EianX/vacuum-forming-machine/prototype/presentation/assembly.jpg

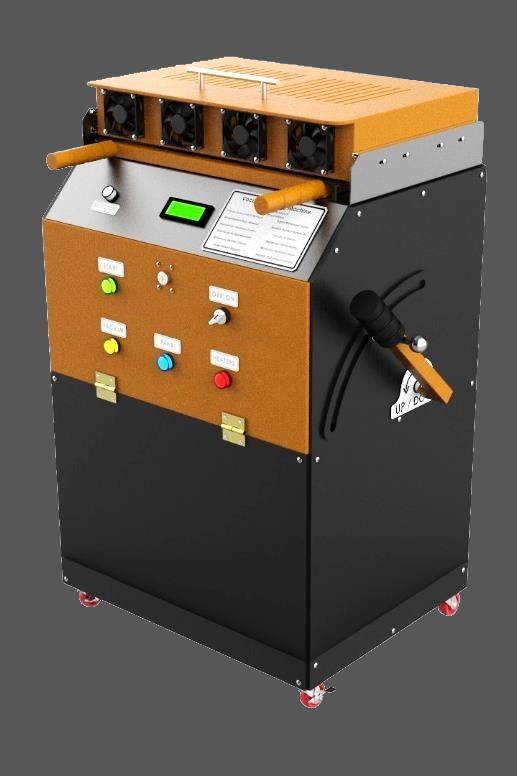
prototype/presentation/assembly.jpg
