EianX/vacuum-forming-machine/prototype/presentation/app.png

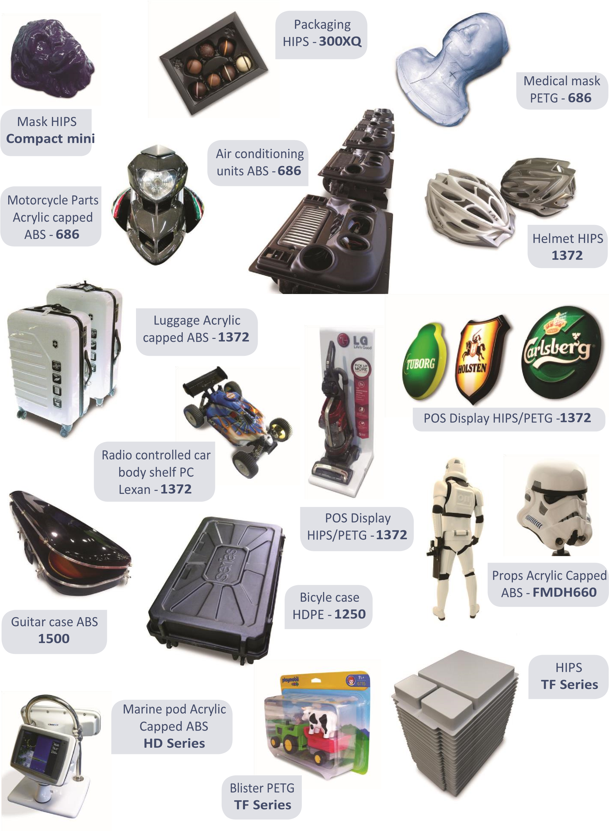
prototype/presentation/app.png
