EianX/vacuum-forming-machine/prototype/presentation/Project 2.pptx

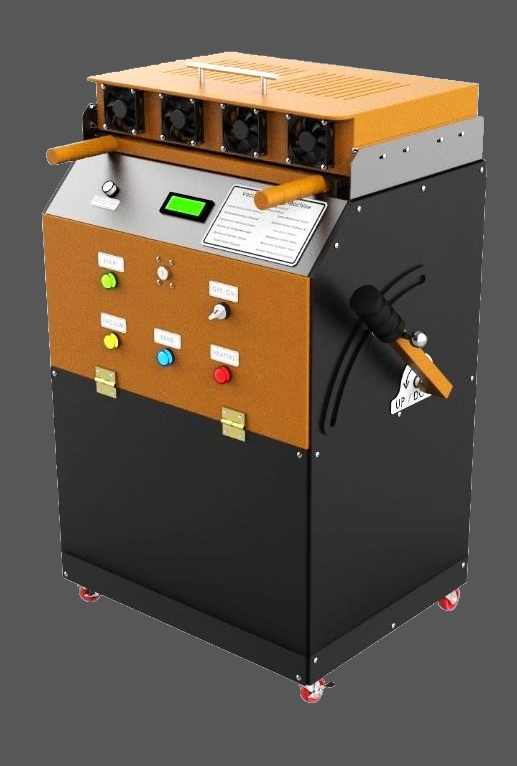
[picture p3: figure]

PROJECT 2

DESIGN & MANUFACTURING OF
MANUAL VACUUM FORMING MACHINE

Under the supervision of
Dr. Mahmoud Mohamed Saafan

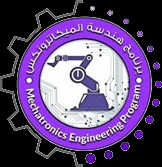
[picture p4: figure]

## Slide 2

WHAT IS IT ?

VACUUM FORMING MACHINE

Vacuum forming is a manufacturing method used to shape plastic materials. During the vacuum forming process, a sheet of plastic is heated and then pulled around a single mold using suction.
Vacuum forming is used for a wide range of manufacturing applications, ranging from small custom parts produced on desktop devices to large parts manufactured on automated industrial machinery.

## Slide 3

VACUUM FORMING MACHINE

DISCUSSION FLOW

Mechanical Portion
Hardware Portion
Software Portion
Applications

## Slide 4

Mechanical Portion

HASAN MOHAMED HASAN

MOHAMMED FARIED EL-SOFANY

IBRAHIM HAMED IBRAHIM ALI

KARIM KHALED ELSAYED

MEET THE TEAM

## Slide 5

Mechanical Portion

## Slide 6

VACUUM FORMING MACHINE

DISCUSSION FLOW

Mechanical Portion
Hardware Portion
Software Portion
Applications

## Slide 7

Hardware Portion

ABDELRAHMAN MAMDOUH IBRAHIM

HOSSAM AHMED ABD
EL-MAKSOUD

AMR USRY EL-SHERBINY

MOHAMED ABDALLAH HASSAN

MEET THE TEAM

## Slide 8

Hardware Portion

## Slide 9

VACUUM FORMING MACHINE

DISCUSSION FLOW

Mechanical Portion
Hardware Portion
Software Portion
Applications

## Slide 10

Software Portion

ABDELRAHMAN NASR MAAROOF

MAHMOUD ALI ABDALMONEM

MAHMOUD IBRAHIM OSMAN

MEET THE TEAM

## Slide 11

Software Portion

components

Programming definition:

All programs need data to be added to or removed from code. Data entered into a program, either by the programmer or digitally, are referred to as inputs. These inputs are stored in variables and used to run the program.
In order to keep the user informed about what is happening inside the program, a programmer may choose to include outputs. This is where the data from the program is shown to the user, either on screen or in the form of a physical output such as printouts or signals.

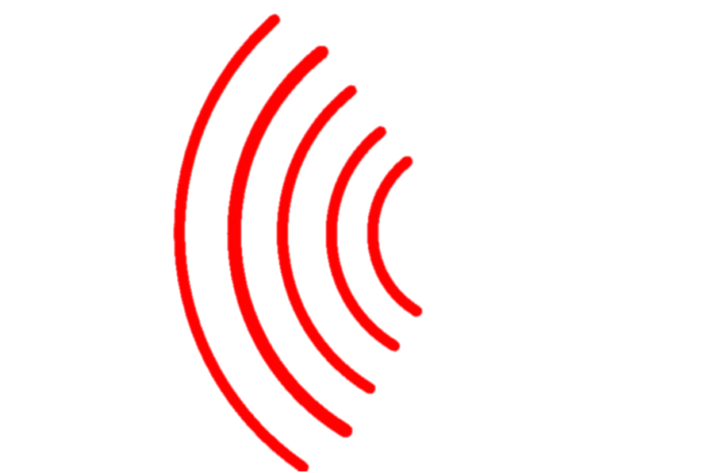
[picture p5: figure]
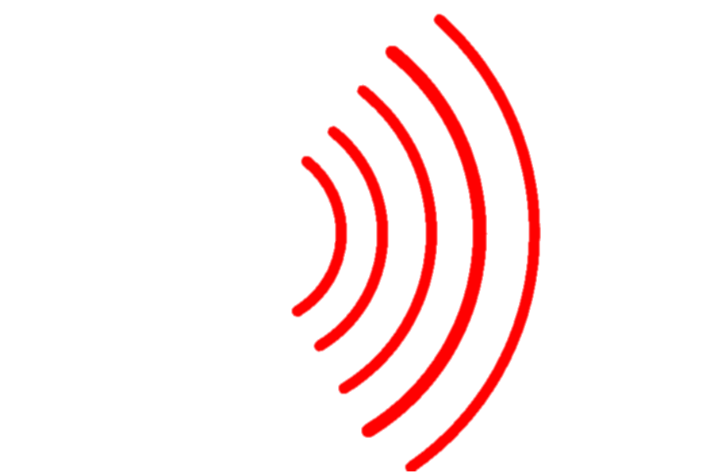
[picture p6: figure]

I/P

- Selector (ON\OFF)
- Encoder selector

O/P

- LCD
- AC lamps
- Buzzer

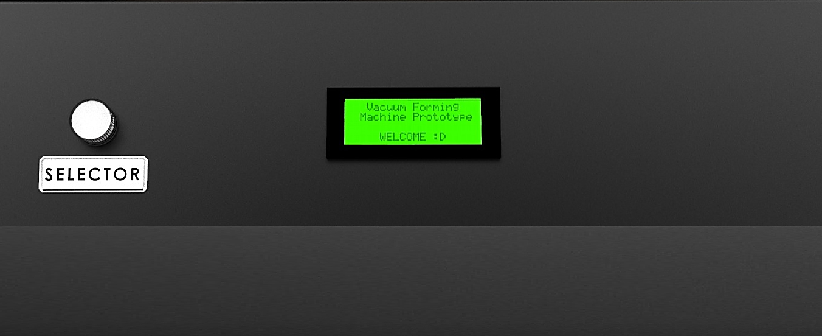
[picture p7: figure]
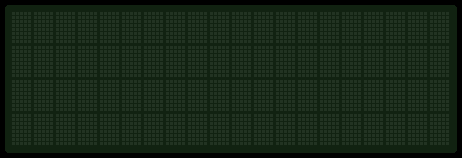
[picture p8: figure]
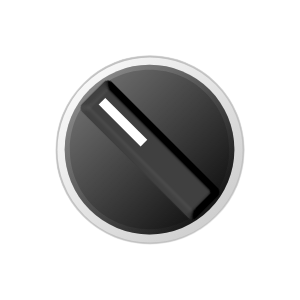
[picture p9: figure]
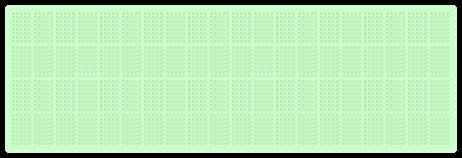
[picture p10: figure]
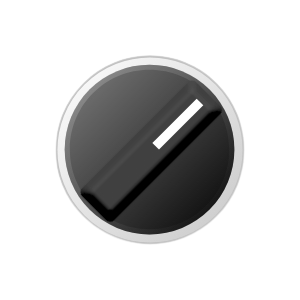
[picture p11: figure]
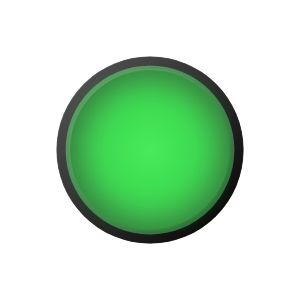
[picture p12: figure]

## Slide 12

Software Portion

ALGORITHM:

1. Import required libraries.
2. Assign due pins.
3. Initialize data variables (Material, Thickness & Temperatures).
4. Initialize LCD.
5. Display on LCD WELCOME message.

Part(1):

Initialization and Void setup.

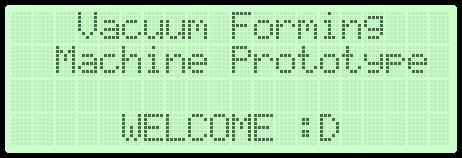
[picture p13: figure]

## Slide 13

Software Portion

ALGORITHM:

6. Display on LCD 1st Menu (Select Material).
7. Read encoder position.
8. Choose the material (PVC/Acrylic/PP).
9. Display on LCD 2nd Menu (Select thickness).
10. Read encoder position.
11. Choose the material thickness (300 µm / 650 µm / 1 mm).
12. Display on LCD 3rd Menu (Preview Chosen Data).
13. Read encoder position.
14. Choose (Continue or not):
  - Continue: Proceed to vacuum forming process.
  - Return: to 1st Menu.

Part(2):

Void loop Stage(0).

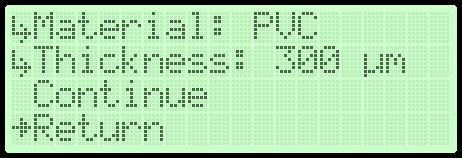
[picture p14: figure]
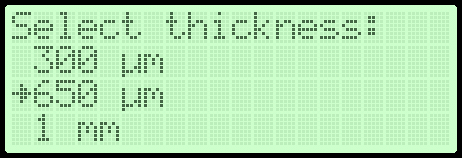
[picture p15: figure]
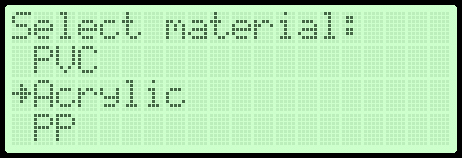
[picture p16: figure]

## Slide 14

VACUUM FORMING MACHINE

DISCUSSION FLOW

Mechanical Portion
Hardware Portion
Software Portion
Applications

## Slide 15

Applications

## Slide 16

VACUUM FORMING MACHINE

DISCUSSION FLOW

Mechanical Portion
Hardware Portion
Software Portion
Applications

## Slide 17

THANK YOU!
