EianX/vacuum-forming-machine/prototype/Software Z.pptx

## Software

Jahein
Abdo
osman

## Programing: Transform the inputs to outputs

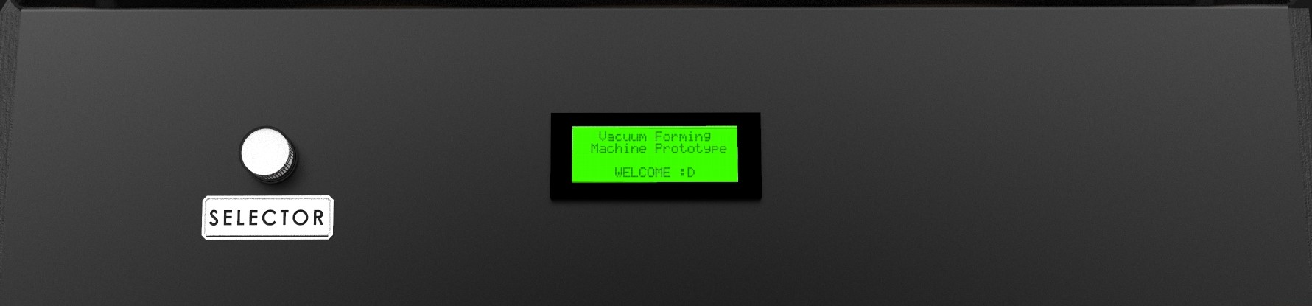
[picture p69: figure]
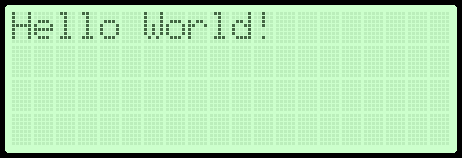
[picture p70: figure]
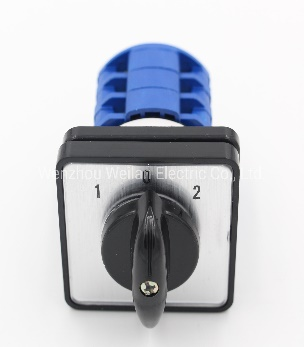
[picture p71: figure]

-Inputs
-Outputs
