EianX/vacuum-forming-machine/prototype/presentation/11.jpg

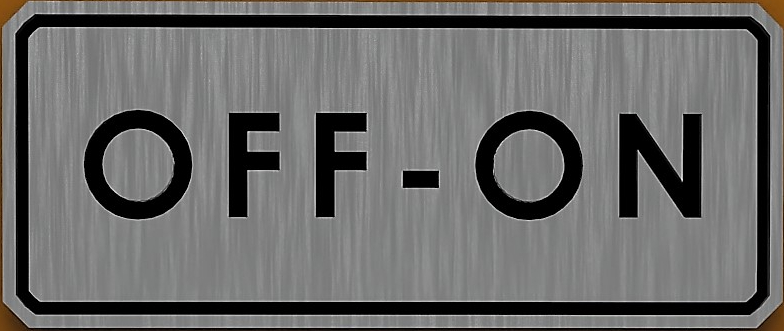
prototype/presentation/11.jpg
