EianX/vacuum-forming-machine/prototype/presentation/main.png

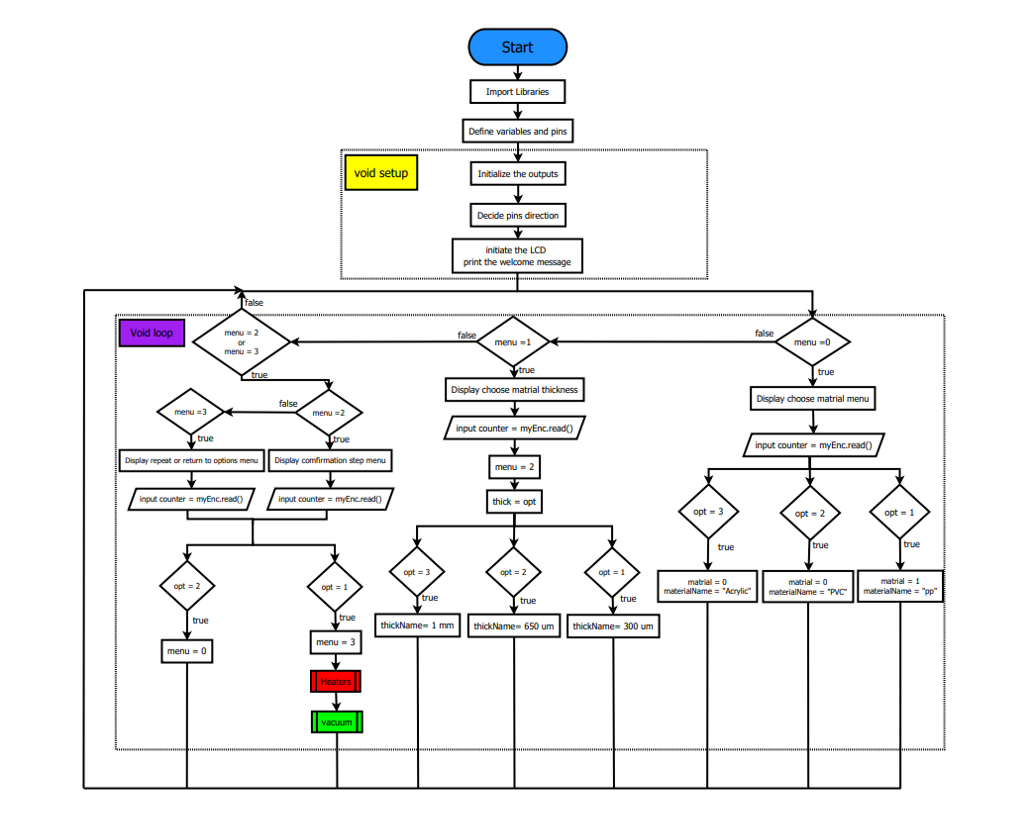
prototype/presentation/main.png
