EianX/vacuum-forming-machine/prototype/presentation/pb-white-br-3d-removebg-preview.png

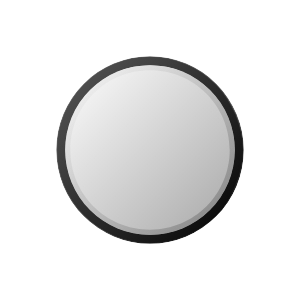
prototype/presentation/pb-white-br-3d-removebg-preview.png
