EianX/vacuum-forming-machine/prototype/presentation/pl-red-br-3d-removebg-preview.png

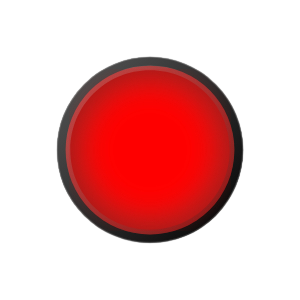
prototype/presentation/pl-red-br-3d-removebg-preview.png
