EianX/vacuum-forming-machine/prototype/presentation/screenshot (2)N.jpg

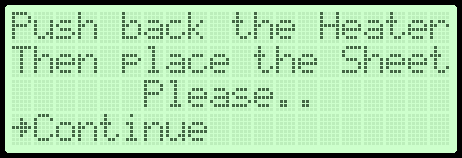
prototype/presentation/screenshot (2)N.jpg
