EianX/vacuum-forming-machine/prototype/presentation/screenshot (4)N.png

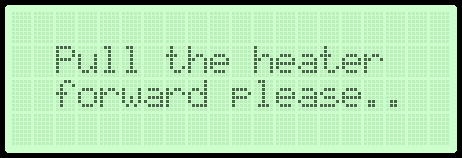
prototype/presentation/screenshot (4)N.png
