EianX/vacuum-forming-machine/prototype/presentation/screenshot (6)N.png

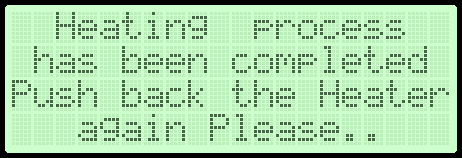
prototype/presentation/screenshot (6)N.png
