EianX/vacuum-forming-machine/prototype/presentation/screenshot (7)N.png

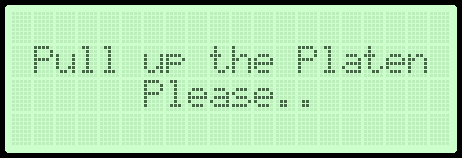
prototype/presentation/screenshot (7)N.png
