EianX/vacuum-forming-machine/prototype/presentation/screenshot (10)N.jpg

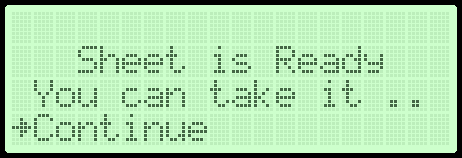
prototype/presentation/screenshot (10)N.jpg
