EianX/vacuum-forming-machine/prototype/presentation/screenshot N1 (1).jpg

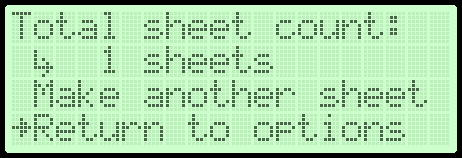
prototype/presentation/screenshot N1 (1).jpg
