EianX/vacuum-forming-machine/prototype/presentation/screenshot N2.png

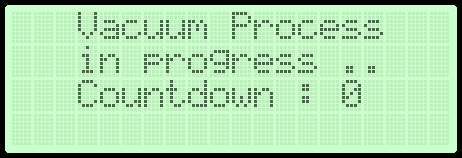
prototype/presentation/screenshot N2.png
