EianX/vacuum-forming-machine/prototype/presentation/screenshot N6.png

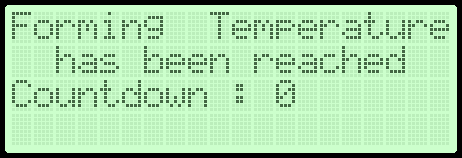
prototype/presentation/screenshot N6.png
