EianX/vacuum-forming-machine/prototype/presentation/screenshot N8.jpg

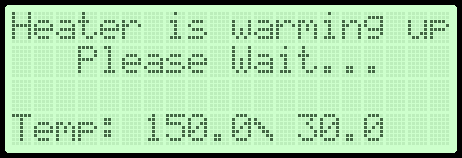
prototype/presentation/screenshot N8.jpg
