EianX/vacuum-forming-machine/prototype/presentation/zzz.jpg

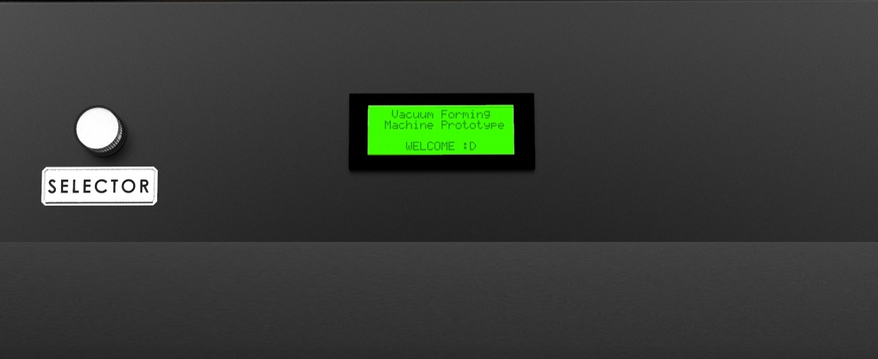
prototype/presentation/zzz.jpg
